engineerdiaa/portable-heart-led/schematic/heart_led_portable.pdf

# 3.7 LiPo D3

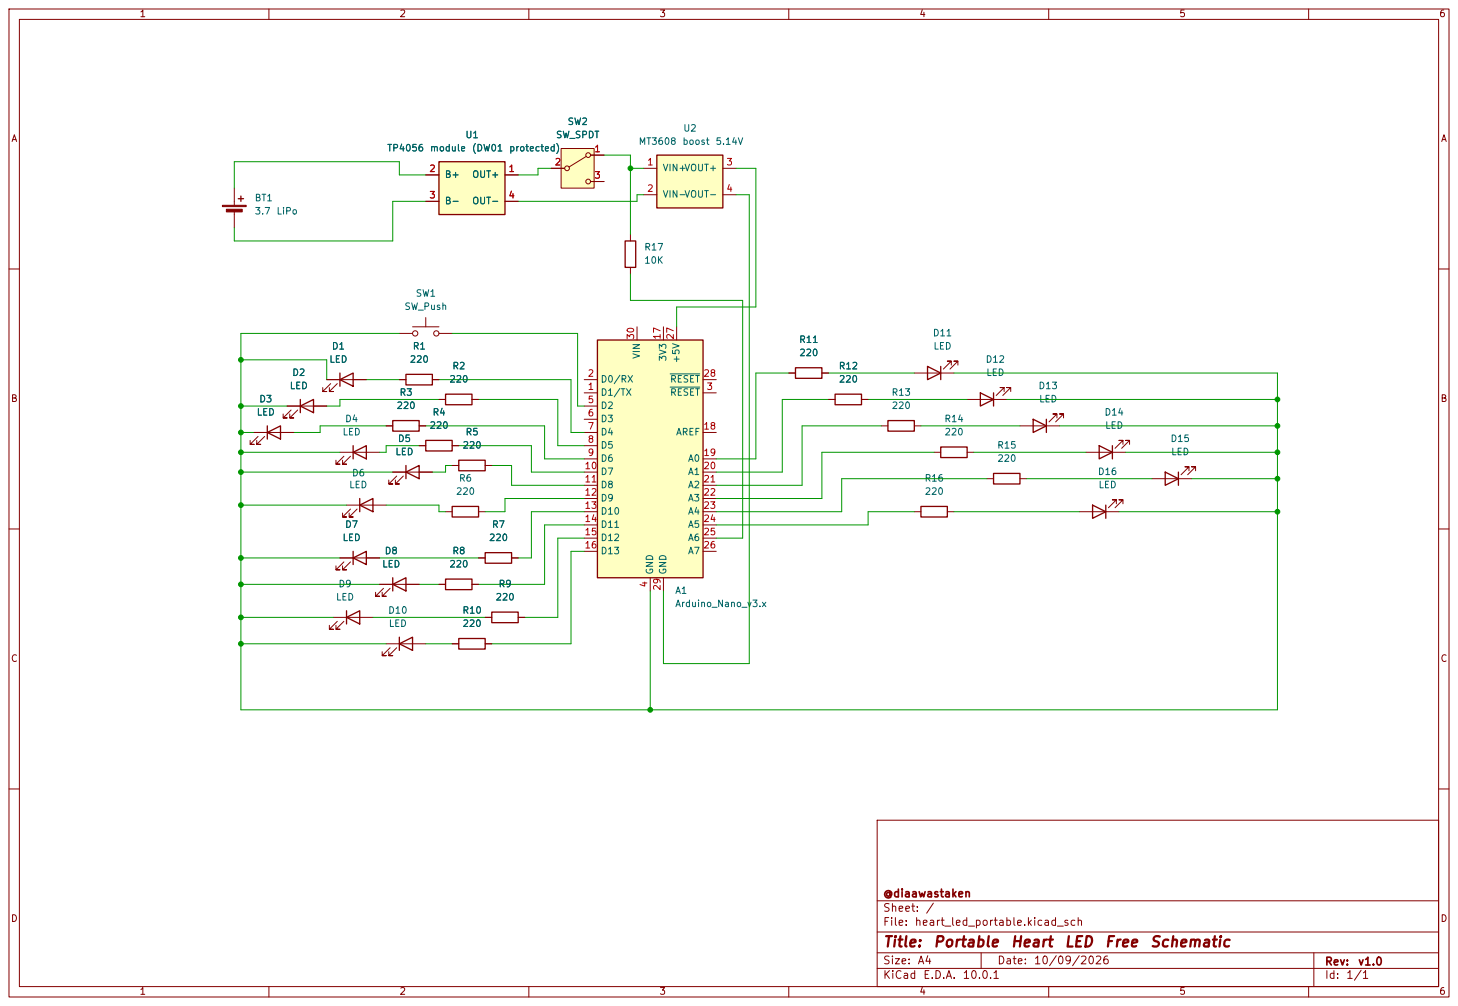
[picture p5: page 1]

@diaawastaken
Sheet: /
File: heart_led_portable.kicad_sch
Title: Portable Heart LED Free Schematic
KiCad E.D.A. 10.0.1
