engineerdiaa/portable-heart-led/(commit log)

2026-10-09 Add Portable Heart LED build guide, schematic and reference diagrams
    - README with parts list, wiring tables, step-by-step build and tips
    - Clean redraws of the LED position map and Nano pinout
    - KiCad schematic PDF
2026-10-09 Add Arduino sketch and document light modes and battery cutoff
    - firmware/heart_led_portable/heart_led_portable.ino (pins verified against schematic)
    - README: 6 light modes, low-battery cutoff, tunable settings, code pin map,
    updated troubleshooting
2026-10-09 Add keychain photos, board layout and keychain build tips
    - Front/back photos of the finished keychain (cropped, no metadata)
    - New Board layout section; pinout described as seen from the back of the board
    - Charge-current table for small LiPos, battery protection tips
    - Strip metadata from the schematic PDF (content unchanged)
    - Keep original source files in a local, git-ignored _originals/ folder
2026-10-25 Add mode 7: auto mode that plays modes 2-6 on a loop, 4 s each
    - New stage 7 sits right before the off stage; the next press turns the heart off
    - Patterns now stop on shouldStop() (button press, or time up in auto mode)
    - autoPatternTime setting (4000 ms) controls how long each pattern plays
    - README: 7 modes, new table row and setting
